PoliTeK/PoliWhanm/README.md

<h1 align="center">
	<br>
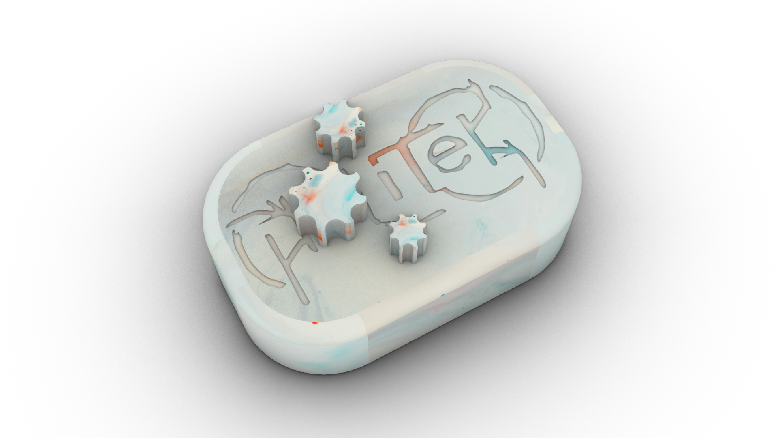
[picture p1: Images/ViewCapture20251205_040147.png]
		
	<br>
		PoliWahnm
	<br>
</h1>

<h4 align="center">A Wireless Controlled Wah Pedal from PoliTeK.</h4>

---

<p align="center">
	<a href="#key-features">Key Features</a> •
	<a href="#list-of-components">List of Components</a> •
	<a href="#how-to-use">How To Use</a> •
	<a href="#credits">Credits</a> •
	<a href="#license">License</a>
</p>

## Key Features

- **... different modes of configuration** (hat, feet, arm, guitar neck, hand).
- **9V Battery slot**, automatically unplugged when using cable power.
- **True Bypass** to deflect the signal directly from input to output when the effect is disabled.

## List of Components (To be Updated after Finished)

### Resistors

| Resistor | Characteristics | Link |
| --- | --- | --- |
| $R1$ | $50\ k\Omega$ | [Mouser](https://www.mouser.it/ProductDetail/YAGEO/RT0603BRD0750KL?qs=qpJ%252B%252B%252Bdg6p2%2FJCmrad8NSA%3D%3D) |
| $R2$ | $1.8\ M\Omega$ | [Mouser](https://www.mouser.it/ProductDetail/Vishay-Beyschlag/MCT06030C1804FP500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) |
| $R3$ | $2.2\ M\Omega$ | [Mouser](https://www.mouser.it/ProductDetail/Vishay/CRCW06032M20FKEA?qs=3X1h7o1miCBXdGAu7crHeg%3D%3D) |
| $R4$ | $10\ k\Omega$ | [Mouser](https://www.mouser.it/ProductDetail/YAGEO/AC0805FR-1310KL?qs=r5DSvlrkXmIkVZsp1lM0Xw%3D%3D) |
| $R5$ | $68\ k\Omega$					 | [Mouser](https://www.mouser.it/ProductDetail/Panasonic/ERJ-6GEYJ683V?qs=gybxhQrZOyFqSdwD0Nnt0g%3D%3D) 				 |
| $R6$ | $1.5\ k\Omega$ | [Mouser](https://www.mouser.it/ProductDetail/Vishay/CRCW08051K50JNEAC?qs=E3Y5ESvWgWNLaVeuGvgL2w%3D%3D) |
| $R7$ | $22\ k\Omega$ | [Mouser](https://www.mouser.it/ProductDetail/YAGEO/RC0805FR-0722KP?qs=qpJ%252B%252B%252Bdg6p1%252Bujocy6HmmQ%3D%3D) |
| $R8$ | $390\ \Omega$ | [Mouser](https://www.mouser.it/ProductDetail/KOA-Speer/RK73B2ATTD391J?qs=nEPxhbwDDYmySWdMHi8xrQ%3D%3D) |
| $R9$ | $33\ k\Omega$ | [Mouser](https://www.mouser.it/ProductDetail/YAGEO/AF0805JR-0733KL?qs=tggtontpCXOgoKY0nuhjTA%3D%3D) |
| $R10$ | $470\ k\Omega$					  | [Mouser](https://www.mouser.it/ProductDetail/YAGEO/RC0805JR-10470KL?qs=qpJ%252B%252B%252Bdg6p2o1a4CuTWYzg%3D%3D) 				 |
| $R11$ | $470\ k\Omega$ | [Mouser](https://www.mouser.it/ProductDetail/YAGEO/RC0805JR-10470KL?qs=qpJ%252B%252B%252Bdg6p2o1a4CuTWYzg%3D%3D) |
| $R12$ | $82\ k\Omega$ | [Mouser](https://www.mouser.it/ProductDetail/YAGEO/RC0805FR-1082KL?qs=m6lXFsvg5e1xvGFD2D%2F3dA%3D%3D) |
| $R13$ | $1\ k\Omega$ | [Mouser](https://www.mouser.it/ProductDetail/Vishay/RCA08051K00JNEASR?qs=4dK74SdgGtzzeVVdjfchZQ%3D%3D) |
| $R14$ | $10\ k\Omega$ | [Mouser](https://www.mouser.it/ProductDetail/YAGEO/AC0805FR-1310KL?qs=r5DSvlrkXmIkVZsp1lM0Xw%3D%3D) |
| $R15$ | $100\ k\Omega$ | [Mouser](https://www.mouser.it/ProductDetail/YAGEO/TR0805NR-07100KL?qs=8cPjvKtxWv5DyBOOAqXaXg%3D%3D) |

### Capacitors

| Capacitor | Characteristics | Link |
| --- | --- | --- |
| $C1$ | $10 nF$ MLCC | [Mouser](https://www.mouser.it/ProductDetail/KEMET/C0805C103J5GAC7210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) |
| $C2$ | $20 pF$ MLCC | [Mouser](https://www.mouser.it/ProductDetail/KYOCERA-AVX/06035U200JAT2A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) |
| $C3$ | $10 nF$ MLCC | [Mouser](https://www.mouser.it/ProductDetail/KEMET/C0805C103J5GAC7210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) |
| $C4$ | $22 nF$ MLCC| [Mouser](https://www.mouser.it/ProductDetail/Murata-Electronics/GCM21B5C1H223JA16K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) |
| $C5$ | $4.7\mu F$ tantalum | [Mouser](https://www.mouser.it/ProductDetail/KEMET/T491A475K016AT7280?qs=aCtIcw4lozMfqQandxONKQ%3D%3D) |
| $C6$ | $10 nF$ MLCC | [Mouser](https://www.mouser.it/ProductDetail/KEMET/C0805C103J5GAC7210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) |
| $C7$ | $22 nF$ MLCC | [Mouser](https://www.mouser.it/ProductDetail/Murata-Electronics/GCM21B5C1H223JA16K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) |
| $C8$ | $220\mu F$ electrolytic | [Mouser](https://www.mouser.it/ProductDetail/Vishay-BC-Components/MAL213656221E3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) |
| $C9$ | $100 nF$ MLCC | [Mouser](https://www.mouser.it/ProductDetail/KYOCERA-AVX/KAF21BR71H104JM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) |
| $C10$ | $100\mu F$ electrolytic | [Mouser](https://www.mouser.it/ProductDetail/Vishay-BC-Components/MAL214271101E3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) |
| $C11$ | $100 nF$ MLCC | [Mouser](https://www.mouser.it/ProductDetail/KYOCERA-AVX/KAF21BR71H104JM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) |
| $C12$ | $100\mu F$ electrolytic | [Mouser](https://www.mouser.it/ProductDetail/Vishay-BC-Components/MAL214271101E3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) |
| $C13$ | $100 nF$ MLCC | [Mouser](https://www.mouser.it/ProductDetail/KYOCERA-AVX/KAF21BR71H104JM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) |
| $C14$ | $10\mu F$ electrolytic | [Mouser](https://www.mouser.it/ProductDetail/Vishay-BC-Components/MAL214238109E3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) |
| $C15$ | $10\mu F$ electrolytic | [Mouser](https://www.mouser.it/ProductDetail/Vishay-BC-Components/MAL214238109E3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) |

### Diodes

| Diode | Characteristics | Part Number | Link |
| --- | --- | --- | --- |
| $D1$ | Zener diode | `BZX55C9V1-TAP` | [Mouser](https://www.mouser.it/ProductDetail/Vishay-Semiconductors/BZX55C9V1-TAP?qs=yIvl1B2wDi58AVjRvrFTxA%3D%3D) |

### Inductors

| Inductor | Characteristics | Part Number | Link |
| --- | --- | --- | --- |
| $L1$ | $500\ mH$ | `C36-X` | [Mouser](https://www.mouser.it/ProductDetail/Triad-Magnetics/C-36X?qs=y9m3SKnhpLPlfz0DyYWbXA%3D%3D) |

### Microcontrollers

| MCU | Characteristics | Part Number | Link |
| --- | --- | --- | --- |
| $U1$ | Devkit Microcontroller | `ESP32-C3-DevKitM-1` | [Mouser](https://www.mouser.it/ProductDetail/Espressif-Systems/ESP32-C3-DevKitM-1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) |
| $U2$ | Devkit Microcontroller | `ESP32-C3-DevKitM-1` | [Mouser](https://www.mouser.it/ProductDetail/Espressif-Systems/ESP32-C3-DevKitM-1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) |

### Transistors

| Transistor | Part Number | Link |
| --- | --- | --- |
| $Q1$ | `ZTX603` | [Mouser](https://www.mouser.it/ProductDetail/Diodes-Incorporated/ZTX603?qs=zhx2xqPtQQzSVtV6bp63RA%3D%3D) |
| $Q2$ | `MPSA18` | [Mouser](https://www.mouser.it/ProductDetail/Central-Semiconductor/MPSA18-TIN-LEAD?qs=l7cgNqFNU1iVtnZi2z3FUg%3D%3D) |
| $Q3$ | `MPSA18` | [Mouser](https://www.mouser.it/ProductDetail/Central-Semiconductor/MPSA18-TIN-LEAD?qs=l7cgNqFNU1iVtnZi2z3FUg%3D%3D) |
| $Q4$ | `TSM680P06CH X0G` | [Mouser](https://www.mouser.it/ProductDetail/Taiwan-Semiconductor/TSM680P06CH-X0G?qs=5aG0NVq1C4zlg2skZHcgkQ%3D%3D) |

### IC

| IC | Part Number | Link |
| --- | --- | --- |
| Digipot | `MCP41100-E/P` | [Mouser](https://www.mouser.it/ProductDetail/Microchip-Technology/MCP41100-E-P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) |
| PS1 | `R-78E5.0-0.5` | [Mouser](https://www.mouser.it/ProductDetail/RECOM-Power/R-78E50-05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) |

### Connectors and switches

| Component | Link |
| --- | --- |
| Battery Snaps & Contacts | [Mouser](https://www.mouser.it/ProductDetail/Eagle-Plastic-Devices/12BH614A-GR?qs=AUVJHMdIU7wQzMG3L3ucqw%3D%3D) |
| $6.35\ mm$ Audio Jack | [Mouser](https://www.mouser.it/ProductDetail/Schurter/4833.2330?qs=wwP%252BWDYHj0Z3fNxHdwSLYg%3D%3D) |
| $2.1\ mm$ DC Barrel Jack | [Mouser](https://www.mouser.it/ProductDetail/Same-Sky/PJ-102A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) |
| Footswitch | [Mouser](https://www.mouser.it/ProductDetail/E-Switch/FS57003PLT2B2M2QE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) |

## How To Use

To simulate the behaviour of the PCB we designed, we used LTspice ([download here](https://www.analog.com/en/resources/design-tools-and-calculators/ltspice-simulator.html)).

### LTspice Setup

In the SPICE analysis part you will find 4 different .asc files.

1) Wah_SS.asc

In this file you will find a Steady State analysis of the analog wah circuit. Looking through the AUDIO_OUT, the .param command changes the potentiometer value and gives the output analysis of the result.

2) Wah_FT.asc

In this file you will find a Fourier analysis of the analog wah circuit. Looking through the AUDIO_OUT, the .param command changes the potentiometer value and gives the output analysis of the result.

3) Wah_Audio.asc

In this file you will find a Steady State analysis of the analog wah circuit, however, you can analyse an actual audio file.
To analyze your own audio file all you have to do is to add the audio file in the same folder so LTSpice can see it, and change the value of the signal generator accordingly.
   
5) Power Management Pedal.asc

In this file you will find a very simple simulation of how the different 9V and 5V power supply lines are generated inside the pedal to control both the analog and the digital circuitry.

### ESP-NOW Protocol Setup

 (To be Updated afterwards)

### Usage of the Complementary Filter

 (To be Updated afterwards)

## Credits

For this project, we used the [Un'analisi circuitale del Wah per chitarra (Crybaby GCB-95)]([https://electrosmash.com/tube-screamer-analysis](https://www.electroyou.it/gill90/wiki/n-a)).

## License

[MIT](https://choosealicense.com/licenses/mit/)

---

<p align="center">
	<a href="mailto:info.politek23@gmail.com">E-Mail</a> •
	<a href="https://www.instagram.com/politek_music">Instagram</a> •
	<a href="https://t.me/+dLKMAwzNmQYxNzM0">Telegram Community</a>
</p>

### Compliation of the Libraries
TBA

TBA in more detail later.
