PoliTeK/PoliWhanm/Images/Breadboard-Prototype-1.jpeg

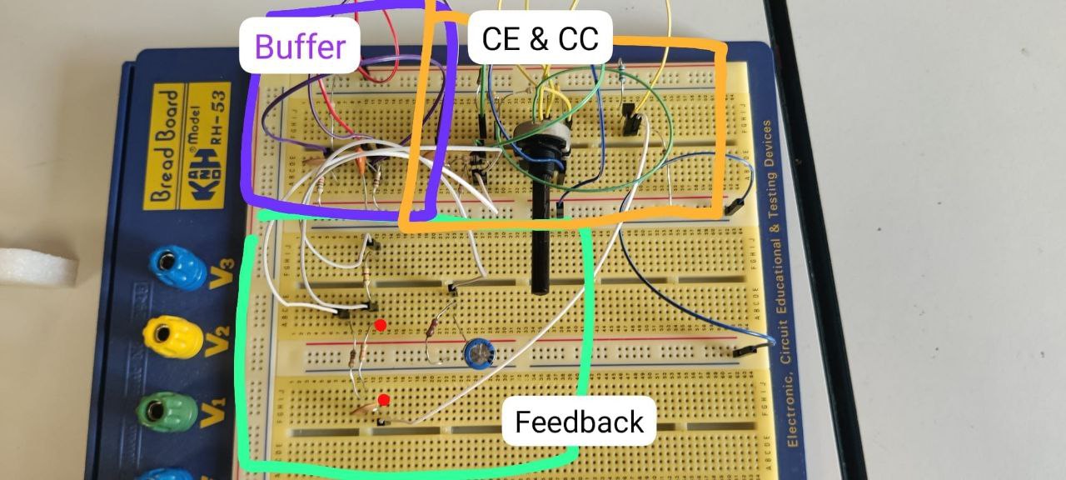
Images/Breadboard-Prototype-1.jpeg
