PoliTeK/PoliWhanm/Images/Breadboard-Prototype-2.jpeg

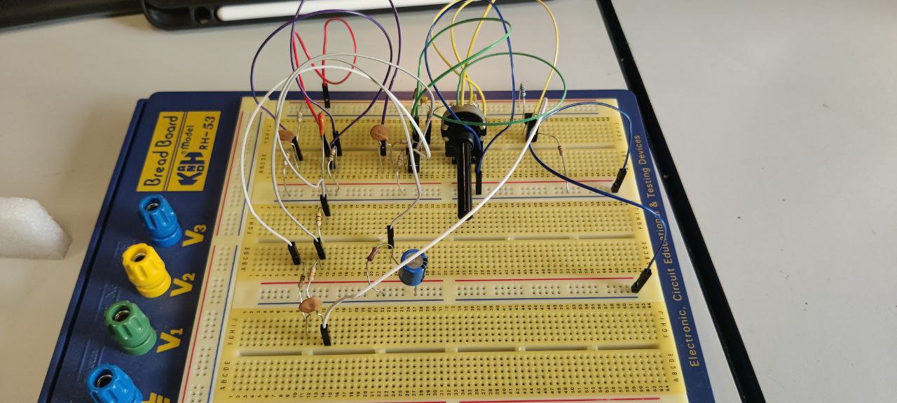
Images/Breadboard-Prototype-2.jpeg
