PoliTeK/PoliWhanm/Images/CryBaby-GCB-95-Circuit.jpeg

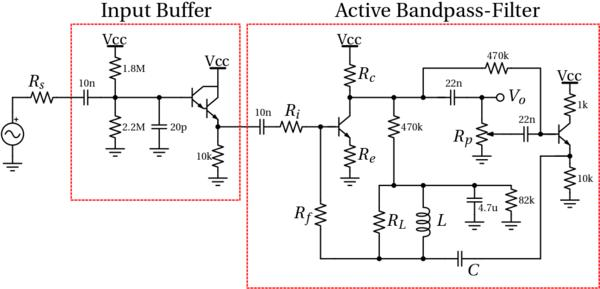
Images/CryBaby-GCB-95-Circuit.jpeg
