PoliTeK/PoliWhanm/Images/Fourier-Simulation.png

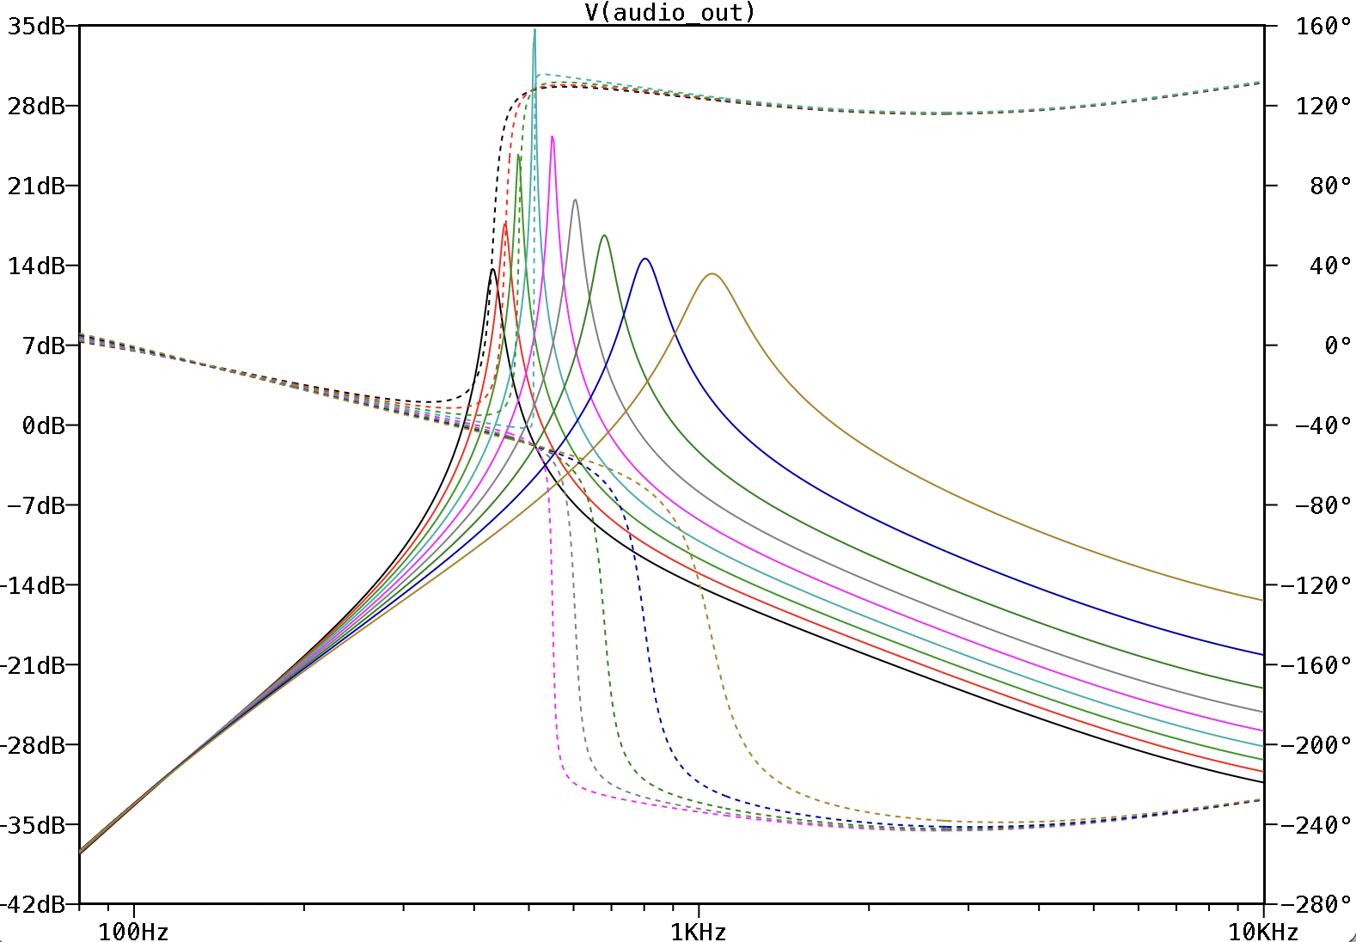
Images/Fourier-Simulation.png
