PoliTeK/PoliWhanm/Images/Pedal-PCB-NoBackground.png

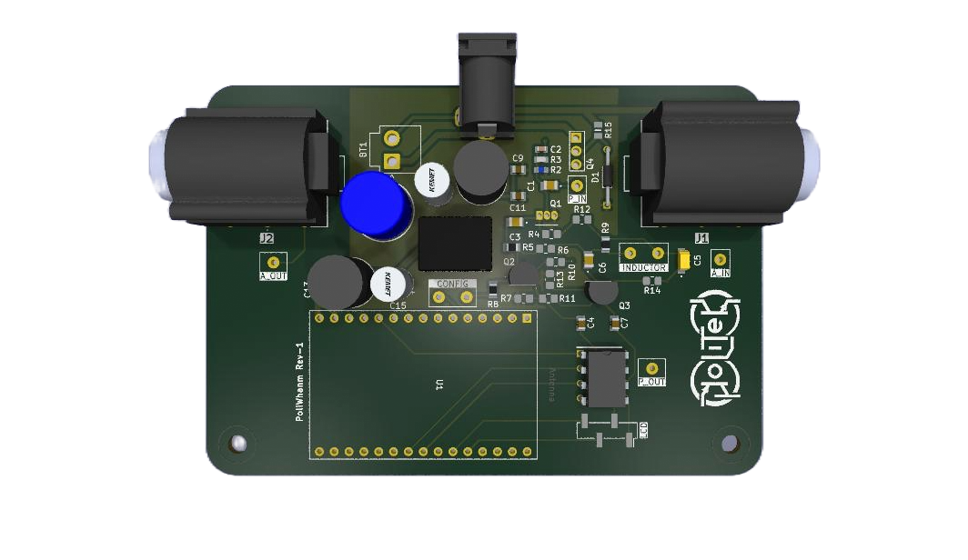
Images/Pedal-PCB-NoBackground.png
