PoliTeK/PoliWhanm/Images/Pedal-PCB-RayTracing-NoBackground.png

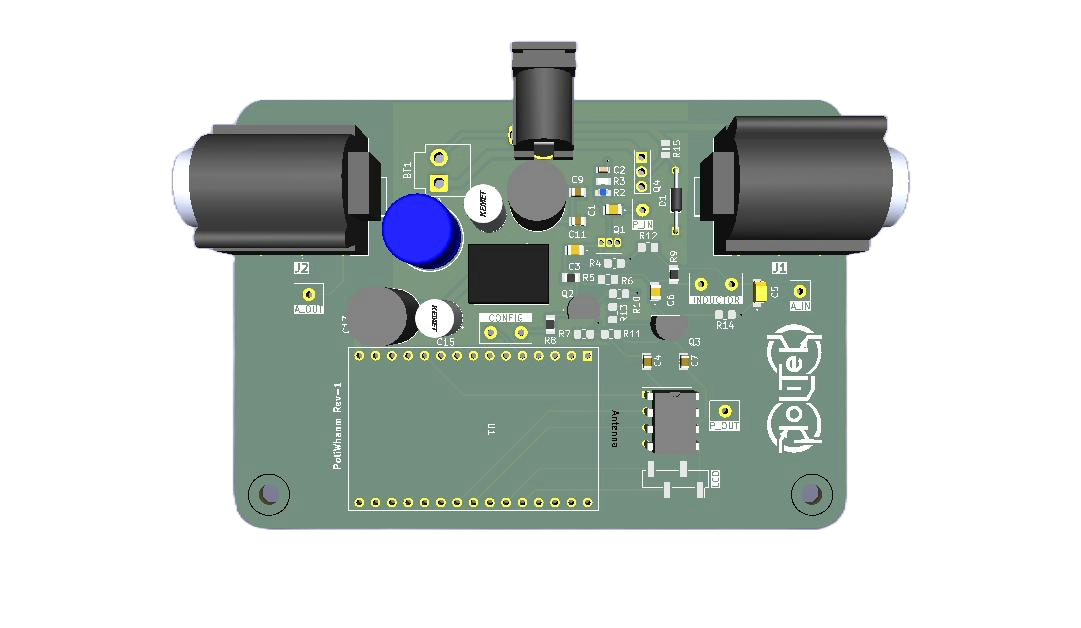
Images/Pedal-PCB-RayTracing-NoBackground.png
