PoliTeK/PoliWhanm/Images/Pedal-PCB.jpeg

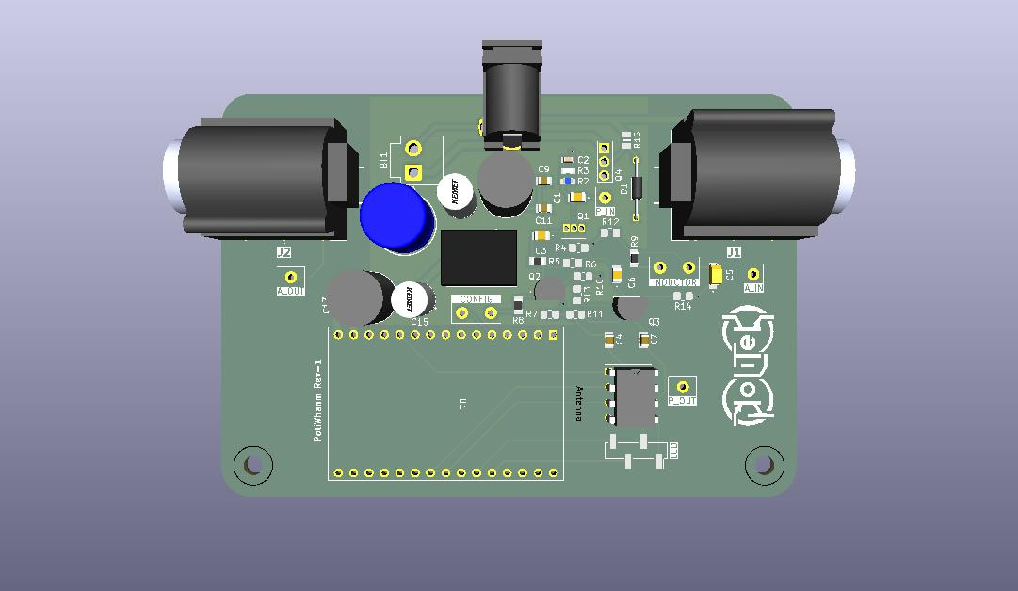
Images/Pedal-PCB.jpeg
