PoliTeK/PoliWhanm/Images/Prototype-Model-System.png

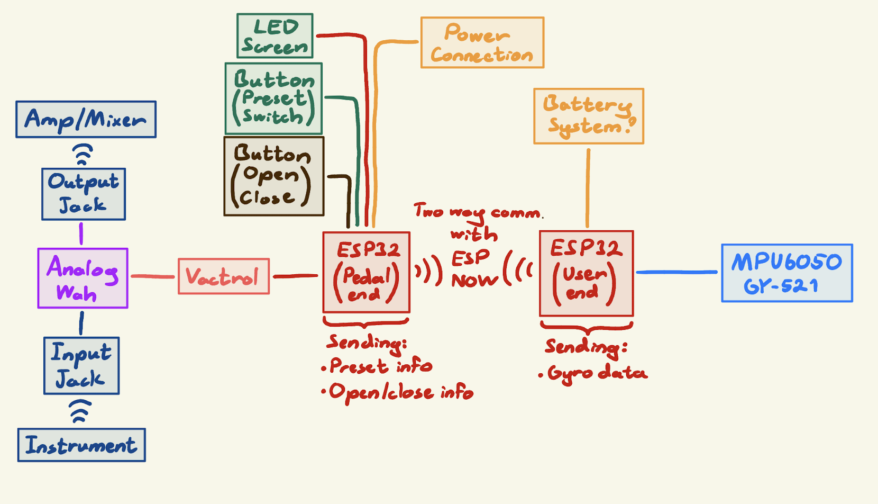
Images/Prototype-Model-System.png
