PoliTeK/PoliWhanm/(commit log)

2025-10-30 add first codes (master, slave)
    master and slave codes for reading and forwarding sensor data. Despite working they need to be checked and eventually optimized.
2026-03-16 LTSpice simulations for wah filter
2026-03-16 SPICE Simulations for power management of the pedal.
2026-03-24 Update resistor specifications and links
    Updated resistor values and links in the README.
2026-03-24 Fix formatting and update resistor links in README
2026-03-24 Fix formatting of resistor values in README
2026-03-24 Revise capacitor section in README
    Updated capacitor specifications and links in README.
2026-03-24 Fix capacitor value formatting in README
    Updated capacitor values from 'nF' and 'pF' to correct formatting.
2026-03-24 Fix formatting of capacitor specifications in README
    Corrected formatting of capacitor specifications in the table.
2026-03-24 Fix spacing in capacitor value descriptions
    Corrected spacing in capacitor values in the README.
2026-03-24 Fix formatting of capacitor characteristics in README
2026-03-24 Update diode information in README
    Replaced a silicon diode entry with a zener diode entry in the README.
2026-05-08 Add section for Complementary Filter usage
